andrew-c-tran/byteshift-fuel-center/hardware/kicad/preview/pcb-back.png

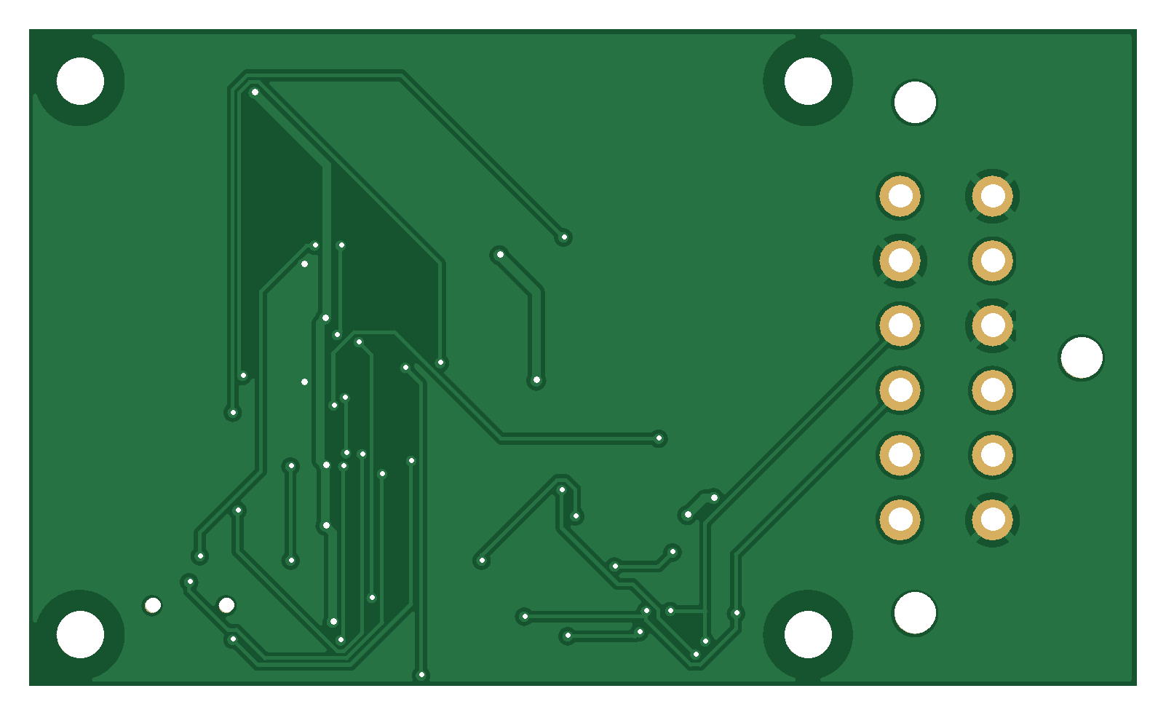
hardware/kicad/preview/pcb-back.png
