andrew-c-tran/byteshift-fuel-center/hardware/BOM.csv

Refs | Qty | Value | MPN | LCSC | Qualification | DNP | Notes
C1 | 1 | 4.7uF 50V | CGA5L1X7R1H475KT0Y0S | C412300 | AEC-Q200 (TDK CGA) |  | input bulk; keep >5 mm from board edge/holes (flex cracking). Alt Samsung CL31B475KBHVPNE C307372
C2,C5,C18 | 3 | 1uF 50V | GCM21BR71H105KA03L | C126592 | AEC-Q200 (Murata GCM)
C3,C4 | 2 | 2.2uF 25V | GCM21BR71E225KA73L | C126591 | AEC-Q200 (Murata GCM)
C6,C7,C8,C9,C10,C11,C12,C19 | 8 | 100nF 50V | CGA3E2X7R1H104KT0Y0N | C76711 | AEC-Q200 (TDK CGA)
C13 | 1 | 22nF 50V | GCM188R71H223KA37J | C3838411 | AEC-Q200 (Murata GCM)
C14 | 1 | 1nF 50V | CL10B102KB8WPNC | C307344 | AEC-Q200 (Samsung P-code)
C15,C16 | 2 | 10pF C0G | GCM1885C2A100JA16D | C126575 | AEC-Q200 Rev D (Murata datasheet GCM1885C2A100JA16-01A) |  | crystal load; alt Samsung CL10C100JB81PNC C307356
C17 | 1 | 4.7nF 50V | GCM188R71H472KA37D | C161228 | AEC-Q200 (Murata GCM) | DNP | split termination centre
D1 | 1 | B340A 40V 3A | B340A-13-F | C85098 | AEC-Q101 (LCSC page) |  | reverse polarity
D2 | 1 | SM8S24A TVS | SM8S24A | C314439 | AEC-Q101 ISO7637-2 (LCSC page) |  | load dump TVS; alt BORN C151945
D3 | 1 | PESD2CAN | PESD2CAN,215 | C75176 | AEC-Q101 (LCSC page) |  | CAN ESD
D4,D5 | 2 | BAT54S | BAT54S-QR | C7507573 | AEC-Q101 (Nexperia BAT54S-Q datasheet) |  | NOT the plain BAT54S (not AEC-Q101)
FB1,FB2 | 2 | 120R 2A | BLM18PG121SH1D | C354394 | AEC-Q200 (Murata H1D, Newark listing) |  | flex sensor 12 V feed
J1 | 1 | DT13-12PA | DT13-12PA | C6423578 | TE Deutsch IP68 (outside AEC-Q200 scope) |  | mating plug DT06-12SA + W12S wedge; if JLC stock is short, add it through JLC Global Sourcing (Mouser/DigiKey stock it)
J2 | 1 | TC2030-NL SWD |  |  | n/a |  | TC2030-NL tag-connect pads, no part
R1 | 1 | 47k | AC0603FR-0747KL | C111134 | AEC-Q200 (Yageo AC)
R2,R5 | 2 | 4.7k | AC0603FR-074K7L | C116697 | AEC-Q200 (Yageo AC)
R8,R9 | 2 | 60.4R | CRCW060360R4FKEA | C844801 | AEC-Q200 (Vishay CRCW) | DNP | split termination; fit only if this node ends the bus
R11 | 1 | 100k | AC0603FR-07100KL | C116674 | AEC-Q200 (Yageo AC)
R12,R3,R4,R6,R7,R13 | 6 | 10k | AC0603FR-0710KL | C116677 | AEC-Q200 (Yageo AC)
TP1 | 1 | UART_RX |  |  | n/a |  | test pad
TP2 | 1 | GND |  |  | n/a |  | test pad
U1 | 1 | S32K116 LQFP-48 | FS32K116LFT0MLFT | C1137392 | AEC-Q100 G1 (NXP family page) |  | run at 5 V; alt FS32K116LFT0MLFR C1850160 (same part on reel)
U2 | 1 | TCAN1042V-Q1 | TCAN1042VDRQ1 | C485806 | AEC-Q100 G1 (LCSC page) |  | alt TJA1042T/3/1J C132227
U3 | 1 | TPS7B6950-Q1 5V | TPS7B6950QDCYRQ1 | C108469 | AEC-Q100 G1 (LCSC page) |  | 5 V 150 mA SOT-223; stable with 2x2.2 uF ceramic; no reverse protection (D1 provides it)
U4 | 1 | TPS7B4250-Q1 track | TPS7B4250QDBVRQ1 | C188757 | AEC-Q100 (TI -Q1) |  | tracking LDO for sensor 5 V; short-circuit protected
U5 | 1 | SN74LVC1G17-Q1 | SN74LVC1G17QDCKRQ1 | C205900 | AEC-Q100 (LCSC page) |  | Schmitt buffer on flex input
Y1 | 1 | 8MHz | NX3225GD-8MHZ-STD-CRA-3 | C889706 | AEC-Q200 (NDK catalog) |  | 8 pF load; the 10 pF load caps assume ~3 pF stray
