andrew-c-tran/byteshift-fuel-center/hardware/kicad/preview/fuel-center-schematic.pdf

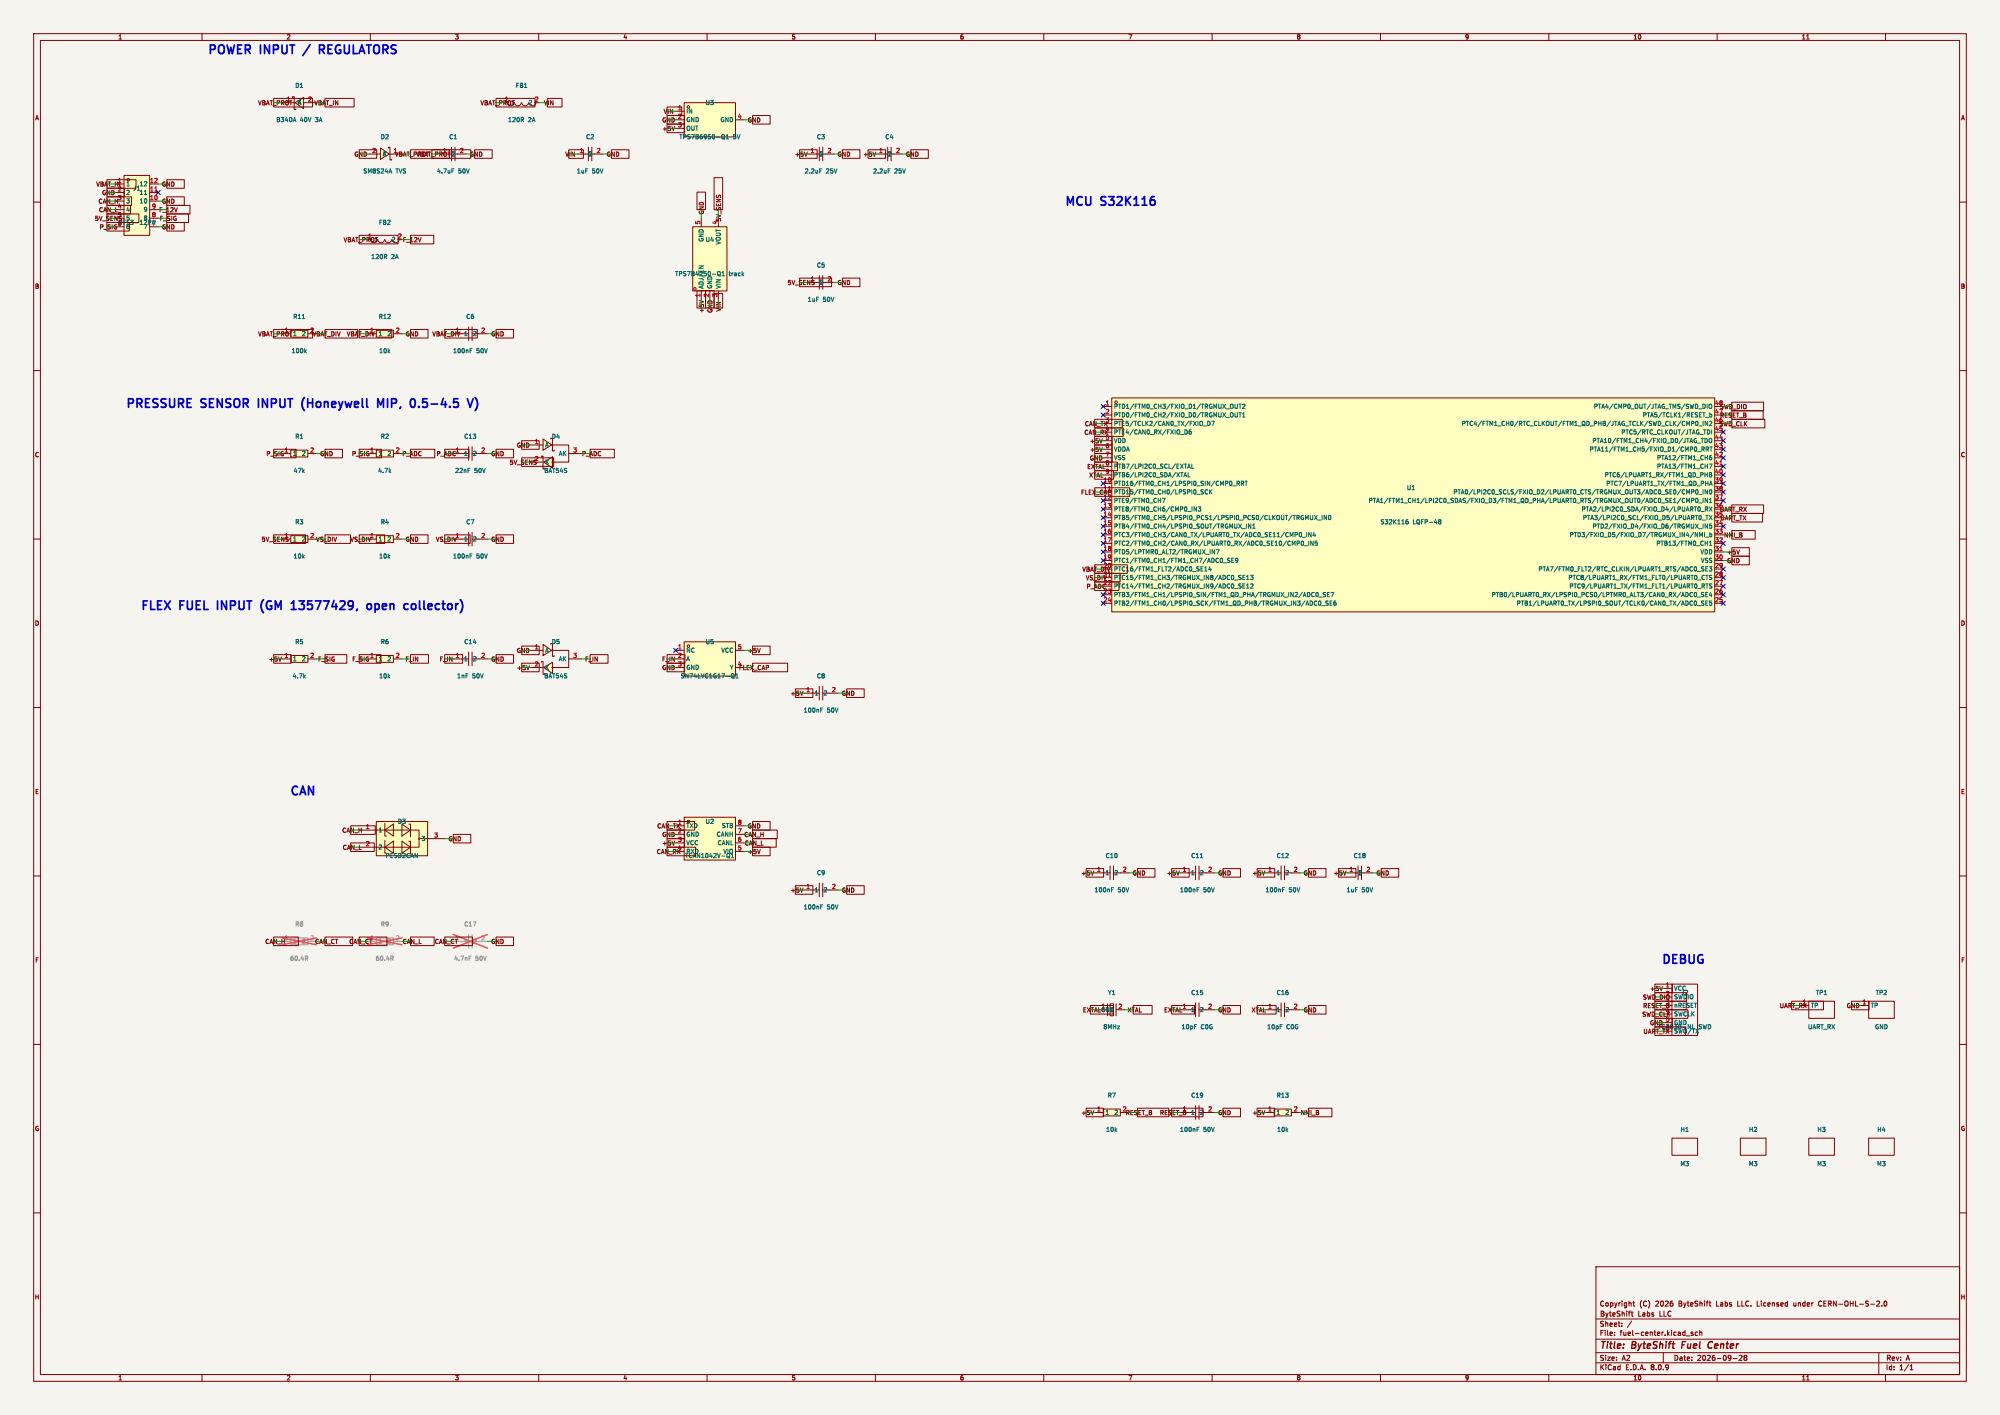
[picture p3: page 1]
