andrew-c-tran/byteshift-fuel-center/hardware/kicad/fuel-center.kicad_pcb

## KiCad design hardware/kicad/fuel-center.kicad_pcb (2026-10-12)

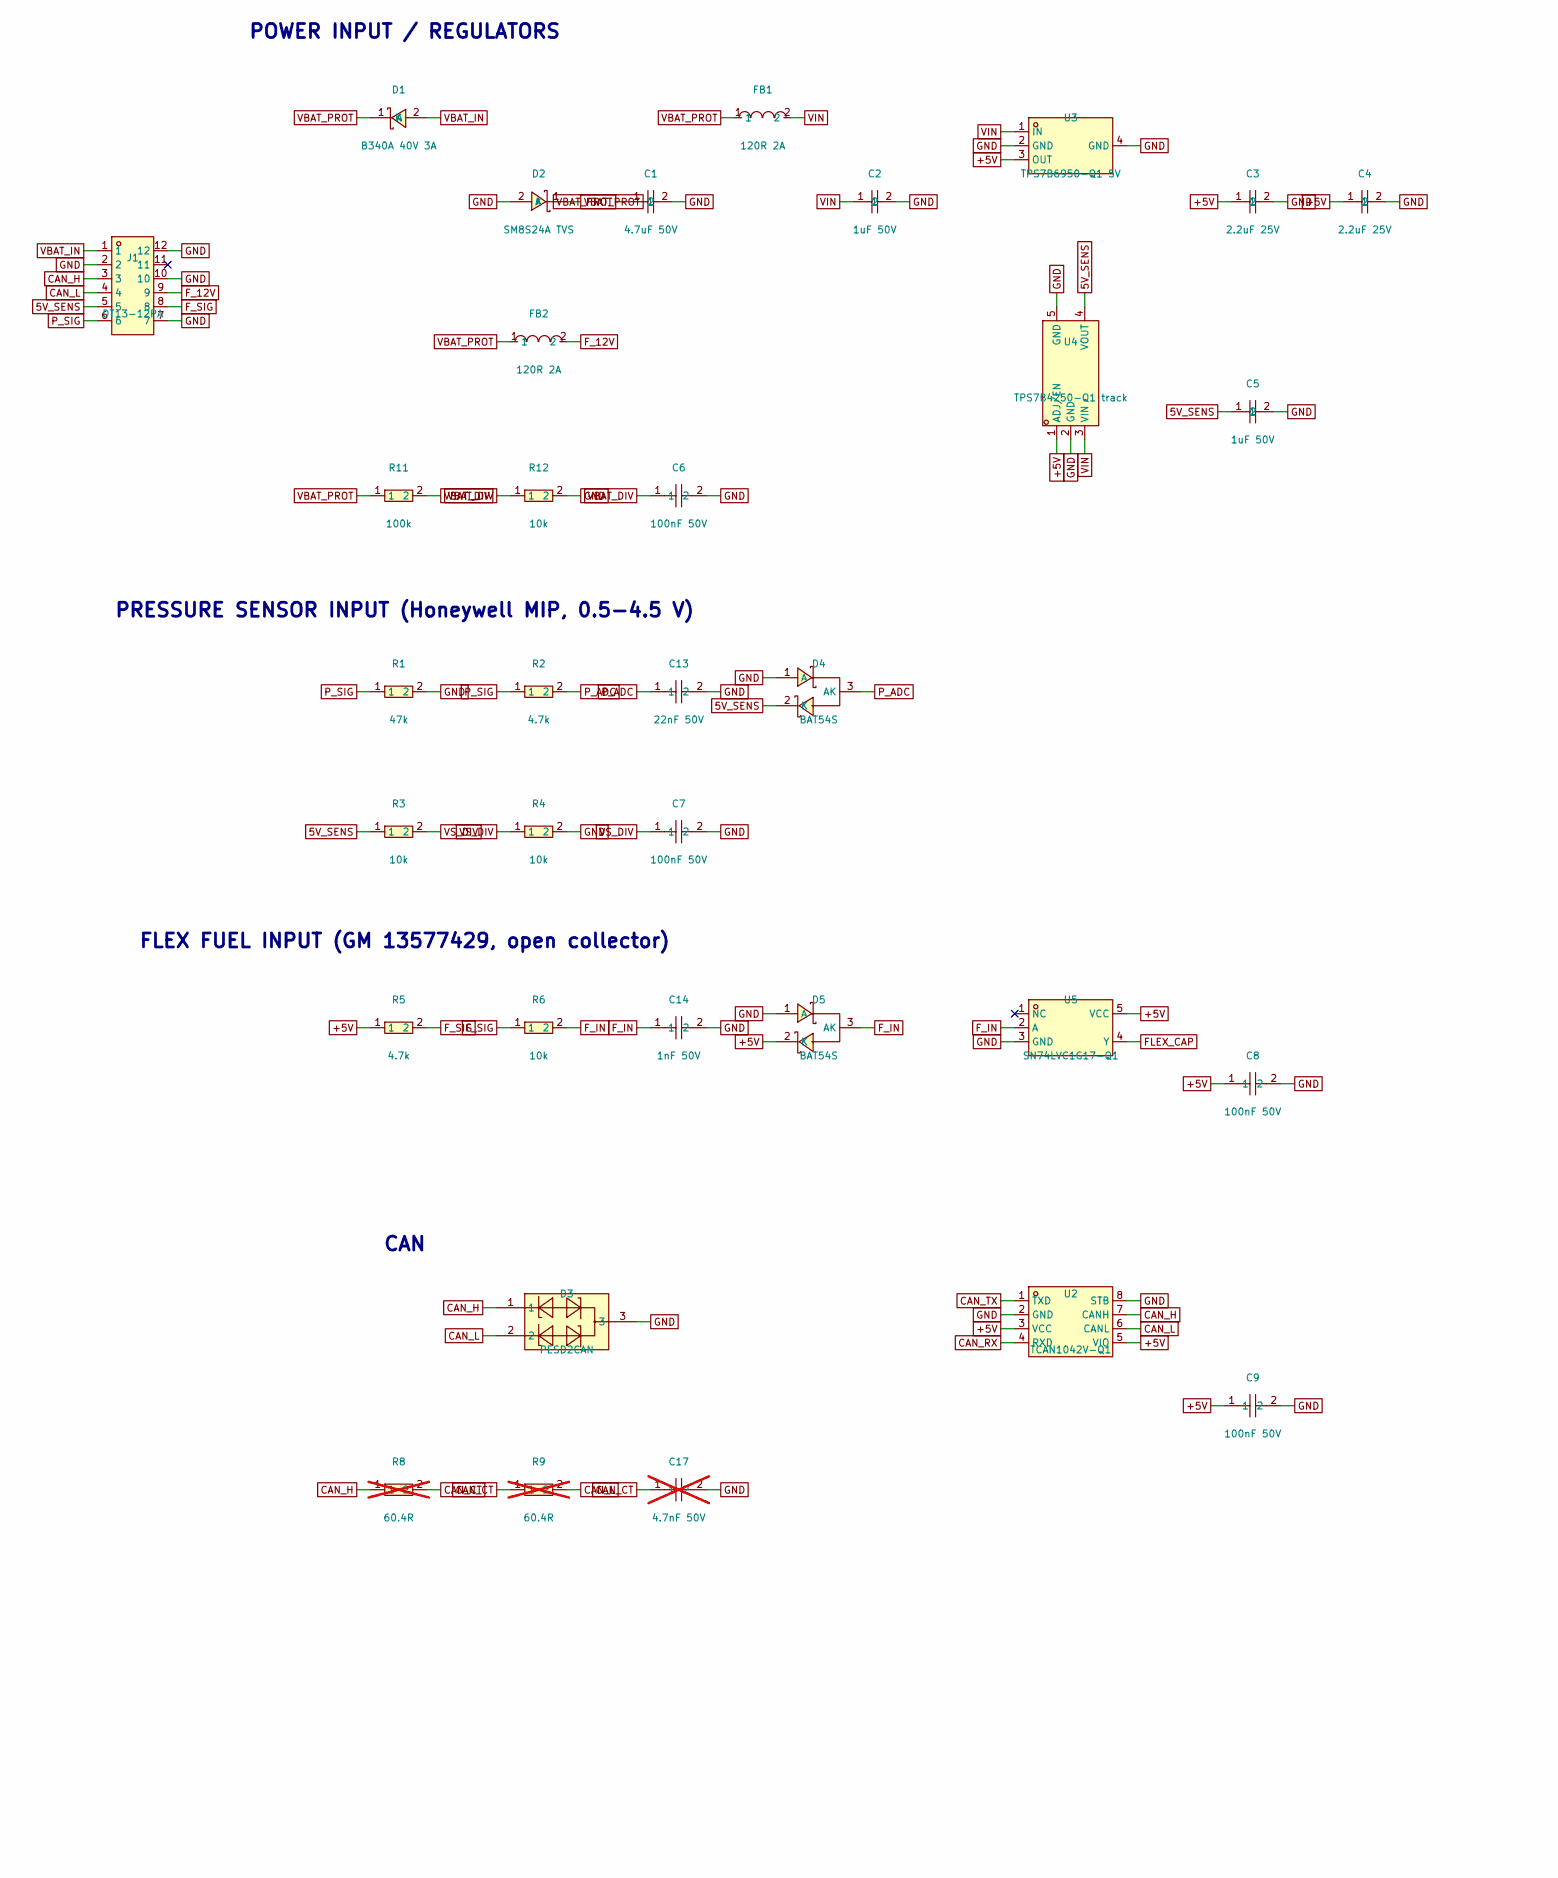
[picture p4: schematic fuel-center.kicad_sch, ByteShift Fuel Center, part in row 1, column 1]

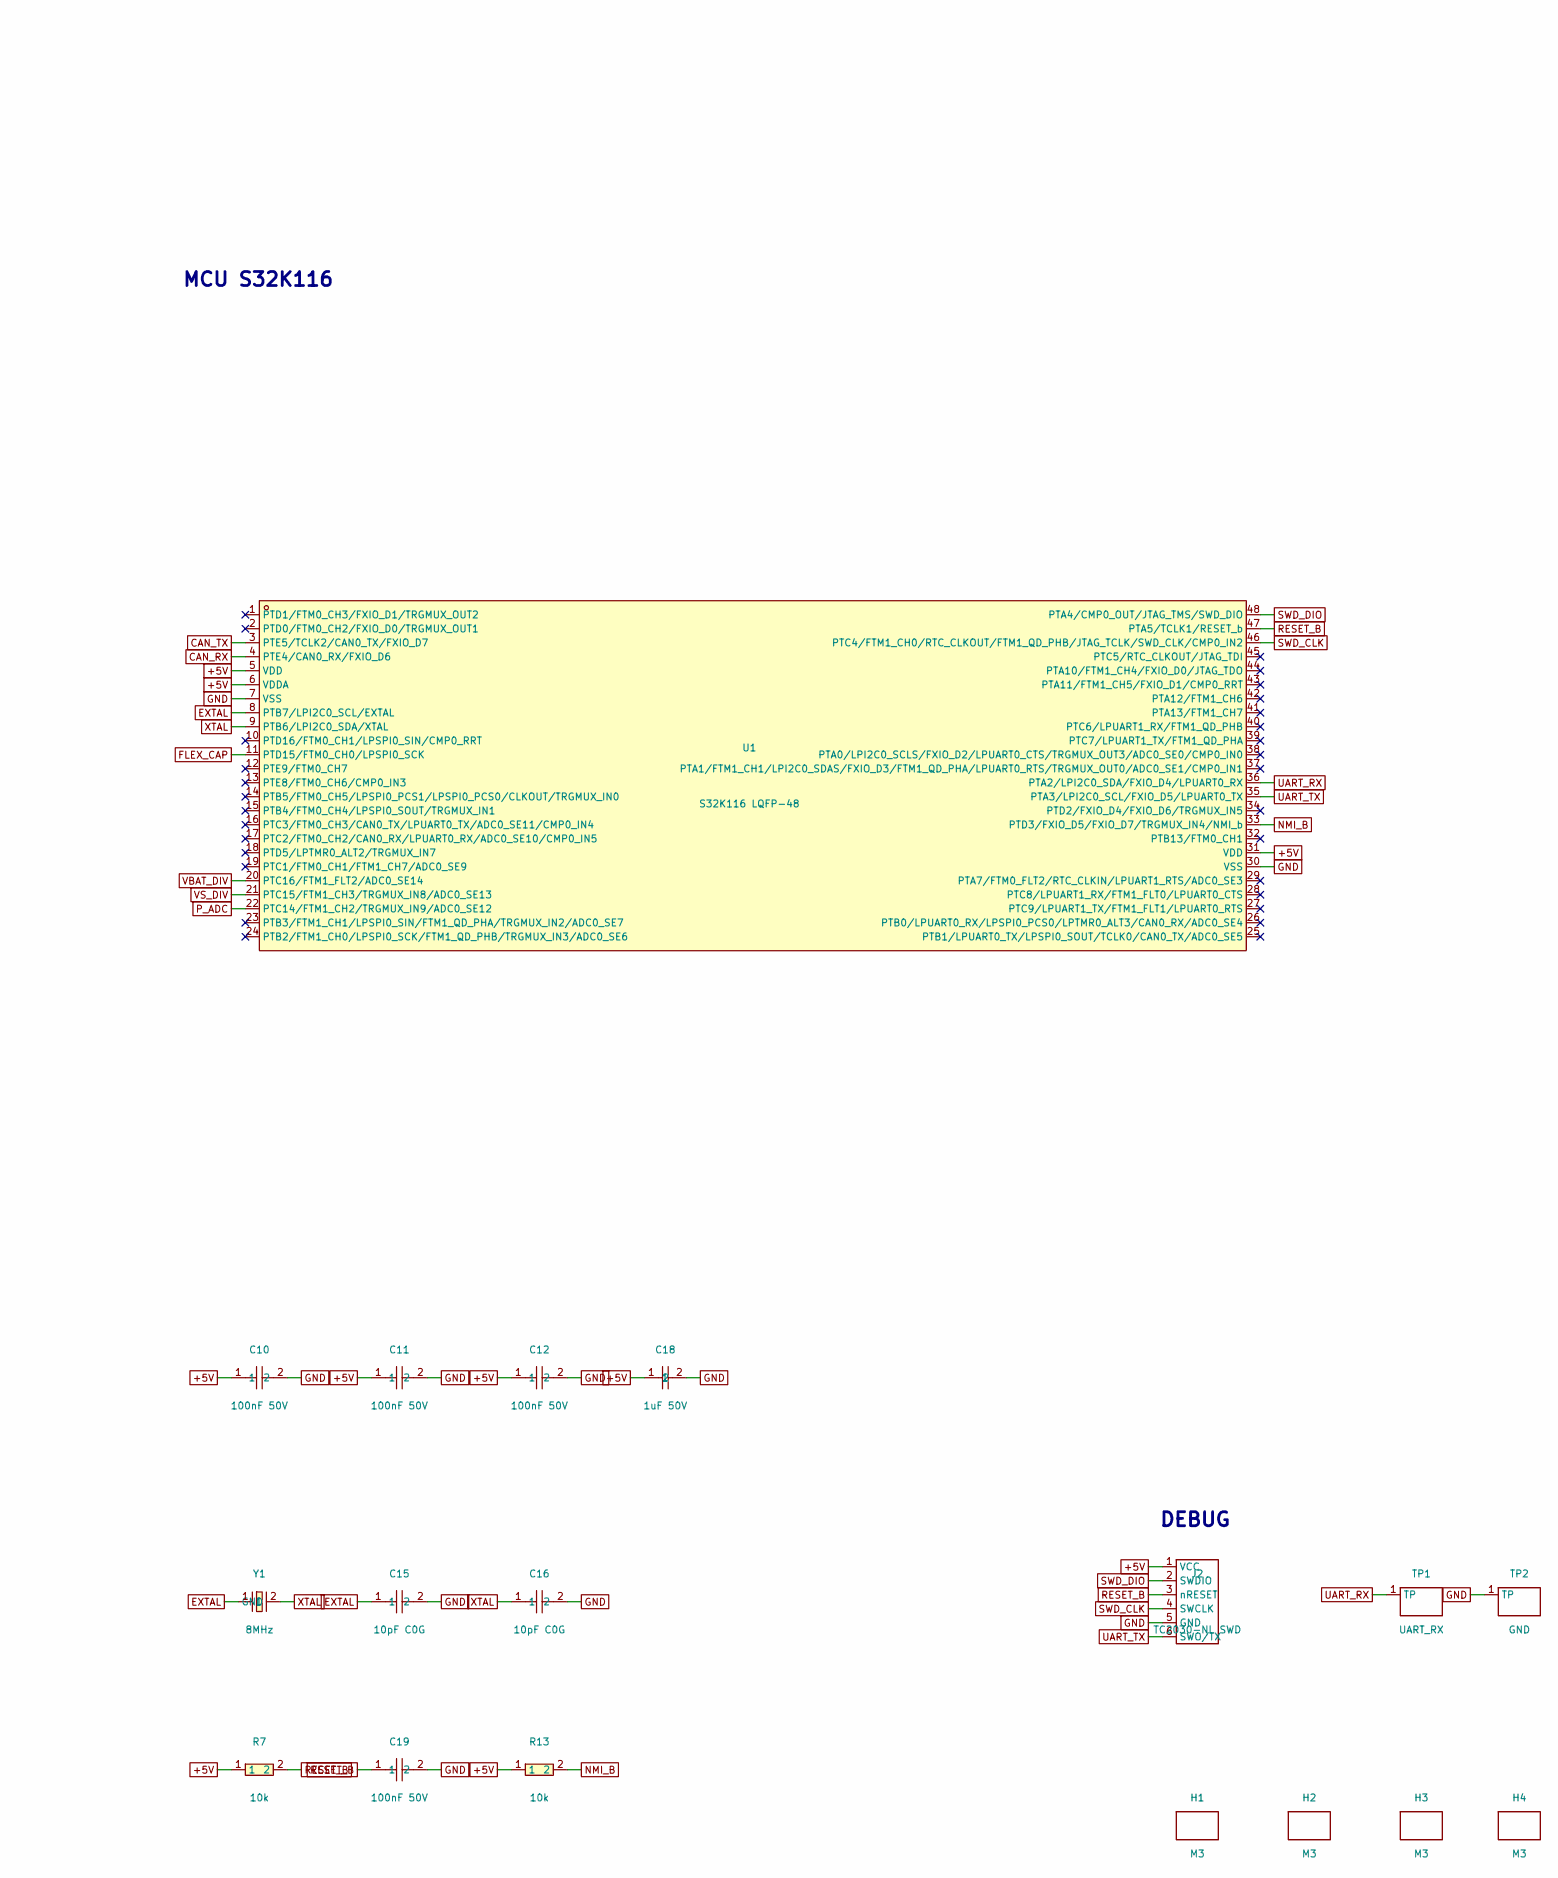
[picture p5: schematic fuel-center.kicad_sch, ByteShift Fuel Center, part in row 1, column 2]

Parts:
C1: 4.7uF 50V; C1206; MPN CGA5L1X7R1H475KT0Y0S; LCSC C412300
C2, C5, C18: 1uF 50V; C0805; MPN GCM21BR71H105KA03L; LCSC C126592
C3, C4: 2.2uF 25V; C0805; MPN GCM21BR71E225KA73L; LCSC C126591
C6, C7, C8, C9, C10, C11, C12, C19: 100nF 50V; C0603; MPN CGA3E2X7R1H104KT0Y0N; LCSC C76711
C13: 22nF 50V; C0603; MPN GCM188R71H223KA37J; LCSC C3838411
C14: 1nF 50V; C0603; MPN CL10B102KB8WPNC; LCSC C307344
C15, C16: 10pF C0G; C0603; MPN GCM1885C2A100JA16D; LCSC C126575
C17: 4.7nF 50V; C0603; MPN GCM188R71H472KA37D; LCSC C161228; not fitted
D1: B340A 40V 3A; SMA_L4.4-W2.6-LS5.0-RD; MPN B340A-13-F; LCSC C85098
D2: SM8S24A TVS; DO-218AB_L13.5-W8.4-LS15.5-FD; MPN SM8S24A; LCSC C314439
D3: PESD2CAN; SOT-23-3_L2.9-W1.3-P1.90-LS2.4-BR; MPN PESD2CAN,215; LCSC C75176
D4, D5: BAT54S; SOT-23-3_L3.0-W1.7-P0.95-LS2.9-BR; MPN BAT54S-QR; LCSC C7507573
FB1, FB2: 120R 2A; L0603; MPN BLM18PG121SH1D; LCSC C354394
H1, H2, H3, H4: M3; MOUNTHOLE
J1: DT13-12PA; CONN-TH_DT13-12PA_C6423578; MPN DT13-12PA; LCSC C6423578
J2: TC2030-NL SWD; TC2030
R1: 47k; R0603; MPN AC0603FR-0747KL; LCSC C111134
R2, R5: 4.7k; R0603; MPN AC0603FR-074K7L; LCSC C116697
R3, R4, R6, R7, R12, R13: 10k; R0603; MPN AC0603FR-0710KL; LCSC C116677
R8, R9: 60.4R; R0603; MPN CRCW060360R4FKEA; LCSC C844801; not fitted
R11: 100k; R0603; MPN AC0603FR-07100KL; LCSC C116674
TP1: UART_RX; TESTPOINT
TP2: GND; TESTPOINT
U1: S32K116 LQFP-48; LQFP-48_L7.0-W7.0-P0.50-LS9.0-BL; MPN FS32K116LFT0MLFT; LCSC C1137392
U2: TCAN1042V-Q1; SOIC-8_L4.9-W3.9-P1.27-LS6.0-BL; MPN TCAN1042VDRQ1; LCSC C485806
U3: TPS7B6950-Q1 5V; SOT-223-4_L6.5-W3.5-P2.30-LS7.0-BR; MPN TPS7B6950QDCYRQ1; LCSC C108469
U4: TPS7B4250-Q1 track; SOT-23-5_L3.0-W1.7-P0.95-LS2.8-BL; MPN TPS7B4250QDBVRQ1; LCSC C188757
U5: SN74LVC1G17-Q1; SC-70-5_L2.1-W1.3-P0.65-LS2.1-BL; MPN SN74LVC1G17QDCKRQ1; LCSC C205900
Y1: 8MHz; OSC-SMD_2P-L3.2-W2.5; MPN NX3225GD-8MHZ-STD-CRA-3; LCSC C889706

Connections:
5V_SENS: C5.1, D4.2 (K), J1.5, R3.1, U4.4 (VOUT)
+5V: C3.1, C4.1, C8.1, C9.1, C10.1, C11.1, C12.1, C18.1, D5.2 (K), J2.1 (VCC), R5.1, R7.1, R13.1, U1.5 (VDD), U1.6 (VDDA), U1.31 (VDD), U2.3 (VCC), U2.5 (VIO), U3.3 (OUT), U4.1 (ADJ/EN), U5.5 (VCC)
CAN_CT: C17.1, R8.2, R9.1
CAN_H: D3.1, J1.3, R8.1, U2.7 (CANH)
CAN_L: D3.2, J1.4, R9.2, U2.6 (CANL)
CAN_RX: U1.4 (PTE4/CAN0_RX/FXIO_D6), U2.4 (RXD)
CAN_TX: U1.3 (PTE5/TCLK2/CAN0_TX/FXIO_D7), U2.1 (TXD)
EXTAL: C15.1, U1.8 (PTB7/LPI2C0_SCL/EXTAL), Y1.1
FLEX_CAP: U1.11 (PTD15/FTM0_CH0/LPSPI0_SCK), U5.4 (Y)
F_12V: FB2.2, J1.9
F_IN: C14.1, D5.3 (AK), R6.2, U5.2 (A)
F_SIG: J1.8, R5.2, R6.1
GND: C1.2, C2.2, C3.2, C4.2, C5.2, C6.2, C7.2, C8.2, C9.2, C10.2, C11.2, C12.2, C13.2, C14.2, C15.2, C16.2, C17.2, C18.2, C19.2, D2.2 (A), D3.3, D4.1 (A), D5.1 (A), J1.2, J1.7, J1.10, J1.12, J2.5 (GND), R1.2, R4.2, R12.2, TP2.1, U1.7 (VSS), U1.30 (VSS), U2.2 (GND), U2.8 (STB), U3.2 (GND), U3.4 (GND), U4.2 (GND), U4.5 (GND), U5.3 (GND)
NMI_B: R13.2, U1.33 (PTD3/FXIO_D5/FXIO_D7/TRGMUX_IN4/NMI_b)
P_ADC: C13.1, D4.3 (AK), R2.2, U1.22 (PTC14/FTM1_CH2/TRGMUX_IN9/ADC0_SE12)
P_SIG: J1.6, R1.1, R2.1
RESET_B: C19.1, J2.3 (nRESET), R7.2, U1.47 (PTA5/TCLK1/RESET_b)
SWD_CLK: J2.4 (SWCLK), U1.46 (PTC4/FTM1_CH0/RTC_CLKOUT/FTM1_QD_PHB/JT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)
SWD_DIO: J2.2 (SWDIO), U1.48 (PTA4/CMP0_OUT/JTAG_TMS/SWD_DIO)
UART_RX: TP1.1, U1.36 (PTA2/LPI2C0_SDA/FXIO_D4/LPUART0_RX)
UART_TX: J2.6 (SWO/TX), U1.35 (PTA3/LPI2C0_SCL/FXIO_D5/LPUART0_TX)
VBAT_DIV: C6.1, R11.2, R12.1, U1.20 (PTC16/FTM1_FLT2/ADC0_SE14)
VBAT_IN: D1.2 (A), J1.1
VBAT_PROT: C1.1, D1.1 (K), D2.1 (K), FB1.1, FB2.1, R11.1
VIN: C2.1, FB1.2, U3.1 (IN), U4.3 (VIN)
VS_DIV: C7.1, R3.2, R4.1, U1.21 (PTC15/FTM1_CH3/TRGMUX_IN8/ADC0_SE13)
XTAL: C16.1, U1.9 (PTB6/LPI2C0_SDA/XTAL), Y1.2 (GND)

Notes on the sheet:
POWER INPUT / REGULATORS
PRESSURE SENSOR INPUT (Honeywell MIP, 0.5-4.5 V)
FLEX FUEL INPUT (GM 13577429, open collector)
CAN
MCU S32K116
DEBUG

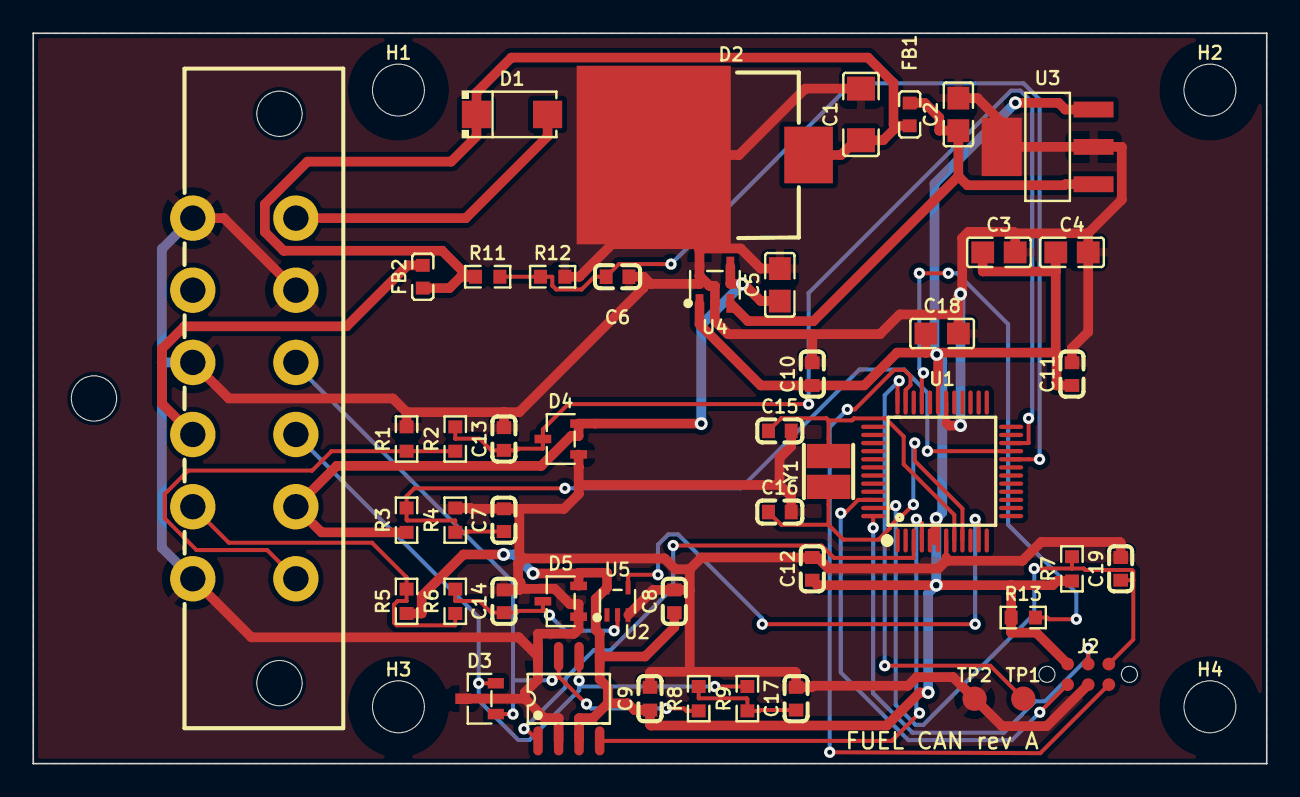
[picture p6: board fuel-center.kicad_pcb from above]

Board: 2 copper layers, 76.0 x 45.0 mm, 52 parts (0 on the bottom side), 27 nets.
