andrew-c-tran/byteshift-fuel-center/(commit log)

2026-10-12 ByteShift Fuel Center rev A
    [BOM.csv, fuel-center.kicad_pcb, fuel-center.kicad_sch, jlc_bom.csv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]
2026-10-12 Render board previews as the real board
    KiCad's SVG export contains invisible copies of every text label, which
    ImageMagick drew as stray labels. The previews are now composed from the
    copper, mask and silkscreen layers: green mask, ENIG pads, white silk.
