andrew-c-tran/byteshift-fuel-center/(notices)

Notices in the files:
hardware/kicad/fuel-center.kicad_sch:
Copyright (C) 2026 ByteShift Labs LLC. Licensed under CERN-OHL-S-2.0
